Ray0516/smart-schoolbag/THIRD_PARTY_NOTICES.md

# 第三方來源與權利

- MFRC522 1.4.12：miguelbalboa/rfid，firmware/EPaperTest/src/MFRC522 保留 UNLICENSE；預設 SPI 從上游 4MHz 改為本案 1MHz。
- TinyGPSPlus 1.1.0：mikalhart/TinyGPSPlus，保留 LGPL-2.1.txt 與原始聲明。
- GxEPD2、Adafruit GFX、Adafruit BusIO 為外部建置依賴，使用時遵循各專案授權；未把套件快取打包成本專案程式。
- Flutter／各 Dart 套件依 pubspec.lock 還原，其授權以套件本身為準。Android／iOS 平台殼層一併收錄。
- ChineseGlyphs 是既有 Windows 微軟正黑體產生的點陣與手調資料，沒有附字型檔。公開再散布或商用前需確認字形與字型授權，或改用允許此用途的開放字型重建；本次不宣稱已取得字型再授權。
- docs/images/wiring.png 含同型模組參考照片；原始來源與圖片權利待公開發行前逐一確認。使用者提供製作實照與建模畫面；此庫依使用者要求公開；照片權利歸原權利人，不另行授權商用。
- 原創部分本次未擅自指定 MIT／其他整體開源授權；請由權利人決定公開散布方式。
