Ray0516/smart-schoolbag/mobile/SmartSchoolbagApp/README.md

# 手機 App

版本 1.5.0+15。請先讀專案根目錄 README.md、docs/BUILD.md、docs/PROTOCOL.md。

此目錄可獨立執行 flutter pub get、flutter analyze、flutter test、flutter build apk --release。不要使用歷史 1.4.x 文件作為目前行為規格。
