Ray0516/smart-schoolbag/docs/FEATURES.md

# 功能狀態、產品需求與未完成項

此表分開「來源已實作」與「實機已驗收」，不要把待做寫成完成。

| 功能 | 目前實作 | 還要完成／驗收 |
|---|---|---|
| 物品資料庫 | 任意名稱、課本／其他分類、UID 配對，最多 20 項 | 新版真實刷卡配對與重連回歸 |
| 星期要帶清單 | 一至日可選，從資料庫勾選；空 override 保持空 | 七日逐項雙向同步、改名與刪除回歸 |
| 勾選 | 手動 OK 與已知 RFID 勾選，重複已完成不重畫 | 驗證實體不誤觸、不重複更新、不漏按 |
| 課表 | 手機自訂科目、每日最多 12 節、每堂課勾選物品；七日文字同步 | 裝置完整臺灣格式週表／逐節格狀表尚非完成產品 |
| 行事曆 | 手機直接新增日期文字、事件／提醒，整合課表行事 | 簡化編輯與日期邊界回歸；不要求匯入 ICS |
| 便利貼 | 最多五則、標題／內容、NVS、讀回比對；裝置清單與詳情分頁 | 新版實機空值、刪除、中文長度與斷線同步 |
| Wi-Fi 自動同步 | 本地 AP／HTTP、前景變更／恢復重試、資料指紋與忙碌保護 | Android 切回其他網路、生命週期與版本相容回歸 |
| 離線使用 | 手機本機保存、裝置 NVS、手動星期 | 重啟後與清單勾選遷移測試 |
| RTC | 手機 TIME 校時，深睡持續；保留手動星期 | 跨日／週、完全斷電後回復，不保證斷電 RTC |
| 五鍵 UI | 直向、左鍵逐層返回、清單分頁、快速導航佇列 | 五鍵實機與刷新中連按合併驗收 |
| 電子紙 | 直向中文、英文基線、黑白反射、定期全刷選項、固定文字 | 核實面板型號；量刷新時間／重影；不能保證無限局刷純黑 |
| 待機 | OK 滿 1.5 秒開始關機畫面、閒置計時、深睡與喚醒邏輯 | 真實長按／持續按住／短按不誤開／USB 插入驗收 |
| 真正切斷外設 | 僅有 GPIO15 可選電源閘控制，預設停用 | 安裝負載開關、避免反向供電與整機電流量測 |
| GPS | NMEA 解析、狀態與有效 fix 才有座標、手機示意／外部地圖連結 | 最後仍 NO FIX；真實戶外定位與地圖回歸 |
| 手機寫卡片名稱 | 現有為手機命令 S3 讀 UID 後配對資料庫 | 通用卡片名稱欄／NDEF／實體寫卡尚未實作 |
| 出門檢查 | 目前清單／完成進度可用 | 專用缺少物品摘要與物品齊全頁尚需設計實作 |
| 放學帶回模式 | 未有獨立狀態模型 | 需獨立每週帶回清單與完成狀態、雙端協定及遷移 |
| 拍照黑白掃描 | 依後續需求延後 | 未實作，先保留文字記事 |
| 雲端／遠端家長 | 不在現有架構 | 無伺服器、登入、遠端即時追蹤或推播 |
| 蜂鳴／LED 遺漏警示 | 沒有確認外接硬體 | 不宣稱已可蜂鳴提示 |
| 電池 UI | 已依要求移除 | 不自行加回 |

## 界面原則

手機採簡約白底與少量青綠點綴，避免重複狀態卡片、重疊說明與多餘頁層。便利貼／行事入口要清楚；裝置主選單直向，底部英文操作提示縮小、版本在右下角。進新頁（含便利貼詳情）全刷，文字沒有左右移動動畫。

## 後續功能的合理邊界

放學帶回不能直接重用上學勾選遮罩，否則早上完成會讓下午誤判齊全。卡片 UID 可被複製，不作安全驗證。App NFC 寫卡能力依手機和標籤類型不同，RC522 也不是所有 NFC／RFID 通用。遠端位置需要額外網路架構；只連本地 AP 沒有雲端能力。
