Ray0516/smart-schoolbag/docs/images/case-model.png

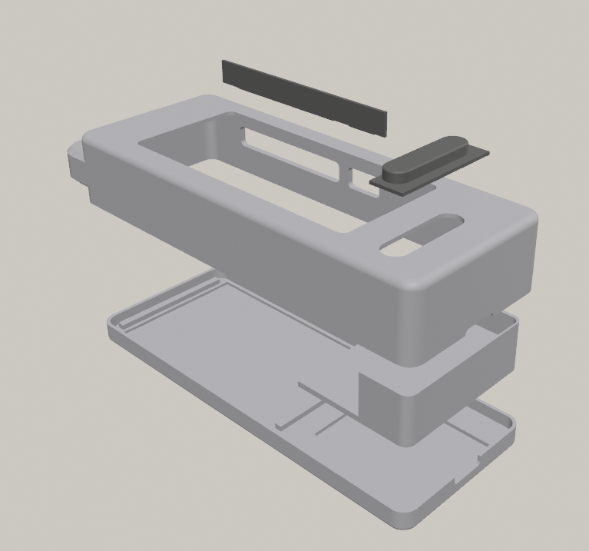
docs/images/case-model.png
