Ray0516/smart-schoolbag/docs/images/assembled-device.jpg

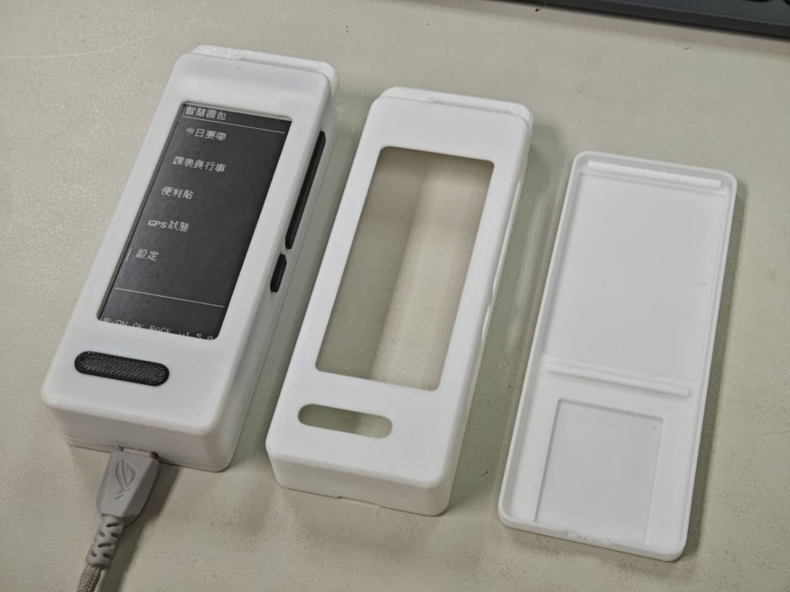
docs/images/assembled-device.jpg
