Ray0516/smart-schoolbag/docs/images/assembly-inside.jpg

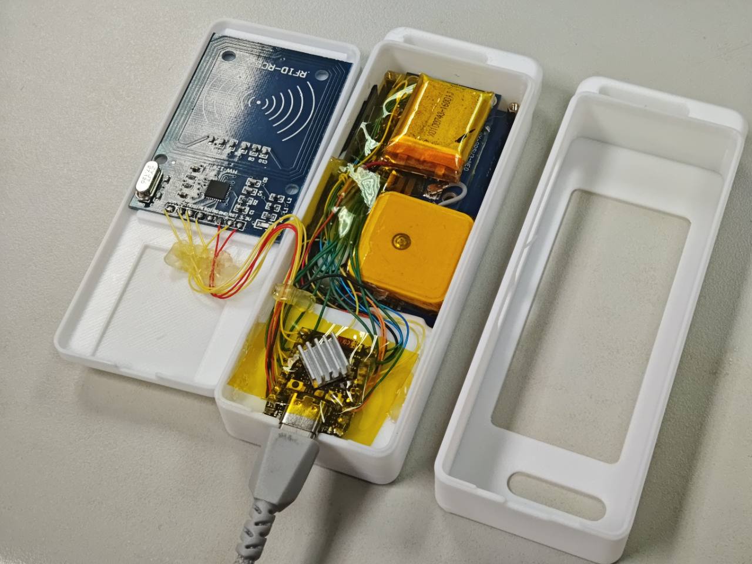
docs/images/assembly-inside.jpg
