Ray0516/smart-schoolbag/docs/images/printed-case.jpg

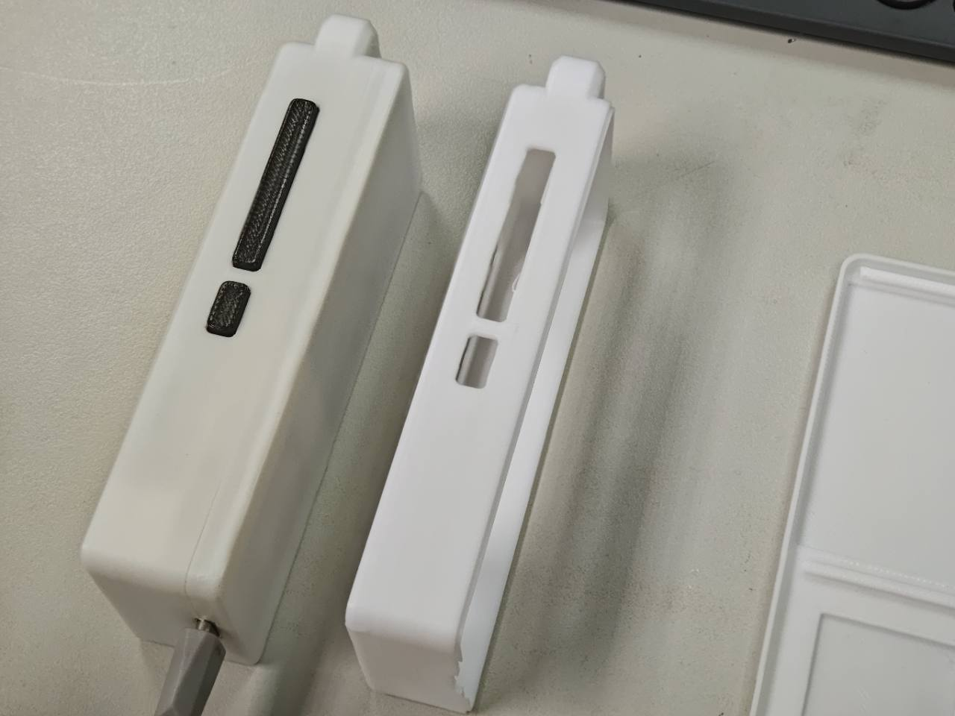
docs/images/printed-case.jpg
