Ray0516/smart-schoolbag/firmware/EPaperTest/src/MFRC522/來源說明.md

# 內建 RC522 驅動

來源：[miguelbalboa/rfid](https://github.com/miguelbalboa/rfid)，library.properties 版本為 1.4.12。

保留原始 MFRC522.cpp、MFRC522.h、deprecated.h、require_cpp11.h 及 UNLICENSE。唯一的上游程式碼調整是將 MFRC522.h 的預設 SPI 時脈由 4MHz 改為 1MHz，供本測試的短線共用 SPI 使用。這個驅動隨 Arduino 草稿碼的 src 資料夾一起編譯，不需另裝 MFRC522 函式庫。
