Ray0516/smart-schoolbag/firmware/EPaperTest/src/TinyGPSPlus/來源說明.md

# TinyGPSPlus

來源：[mikalhart/TinyGPSPlus](https://github.com/mikalhart/TinyGPSPlus)，版本 1.1.0。

TinyGPS++.h 與 TinyGPS++.cpp 保留上游內容及著作權聲明，未修改。授權為 LGPL 2.1 或後續版本，完整文字見同目錄 LGPL-2.1.txt。本測試的接收與畫面邏輯位於 GpsSupport.h 及 EPaperTestApp.h。
