Ray0516/smart-schoolbag/firmware/EPaperTest/LocalWifiConfig.example.h

#pragma once
// Copy to LocalWifiConfig.h, then replace this example with a private 8-63 byte password.
// LocalWifiConfig.h must never be committed. Share the actual password out of band.
#define SCHOOLBAG_WIFI_PASSWORD "REPLACE_WITH_YOUR_PRIVATE_PASSWORD"
