Ray0516/smart-schoolbag/(commit log)

2026-11-05 交接智慧電子書包：S3 韌體、Flutter App、接線與 AI 指令
2026-11-05 排除 Flutter 自動產生的 iOS 註冊檔雜湊
2026-11-05 補齊交接建置驗證與公開版設定步驟
